deadbandlabs/syncro-mainboard/syncro-pcb-lib/GENERATED.md

<!-- Generated by tools/vendor_lib.py (do not edit). -->

# syncro-pcb-lib

- source library revision: 80b2298
- contents: 16 footprints, 9 symbols (dbl-ic 7, dbl-mech 2)
- symbols: dbl-ic.kicad_sym, dbl-mech.kicad_sym
- 3D models are not redistributed: footprints referencing them fall back
  to no model, which KiCad reports as a missing-model warning.
- parts of this library are derived from the KiCad libraries
  (CC-BY-SA-4.0 WITH KiCad-libraries-exception); see ../NOTICE.
