deadbandlabs/syncro-mainboard/syncro-mainboard/syncro-mainboard.kicad_pcb

## KiCad design syncro-mainboard/syncro-mainboard.kicad_pcb (2026-10-27)

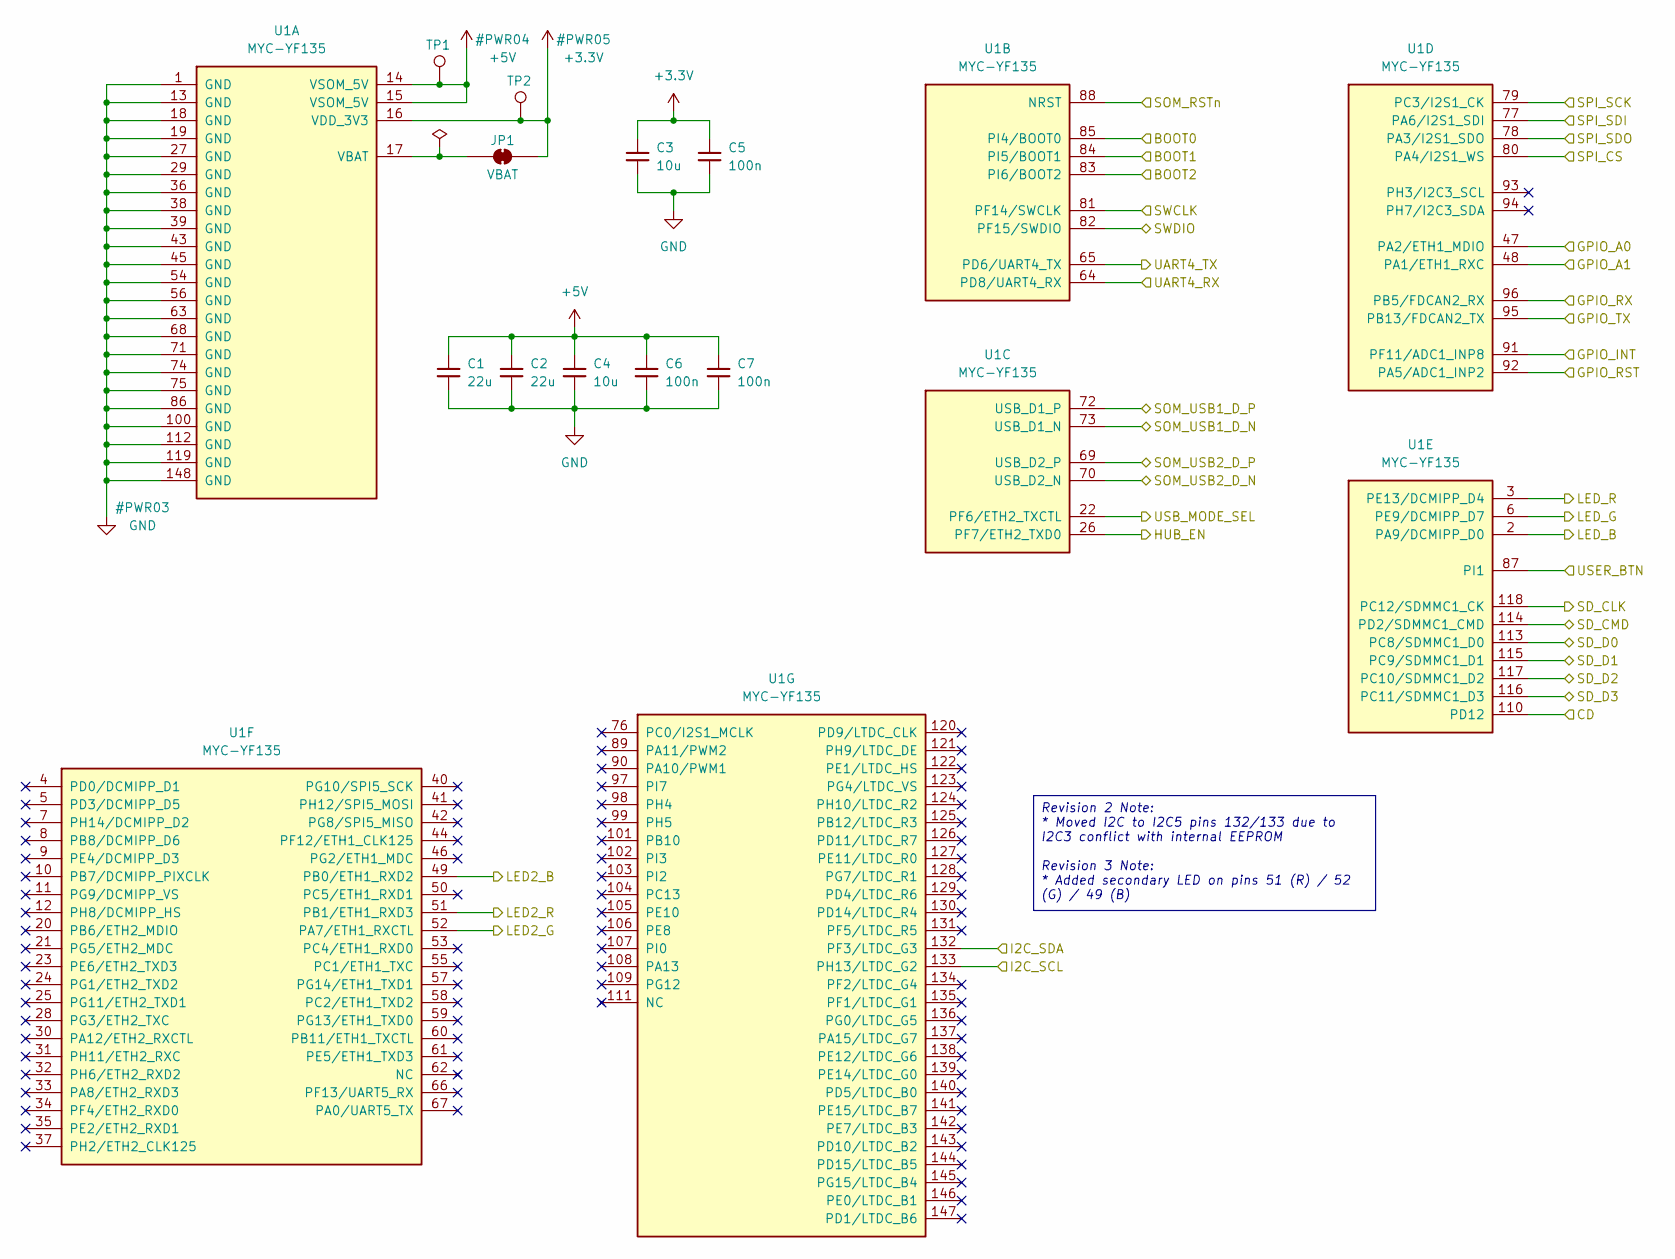
[picture p3: schematic som.kicad_sch, Syncro FFB Interceptor]

Parts:
C1, C2: 22u; C_0805_2012Metric; LCSC C45783
C3, C4: 10u; C_0805_2012Metric; LCSC C15850
C5, C6, C7: 100n; C_0402_1005Metric; LCSC C1525
JP1: VBAT; SolderJumper-2_P1.3mm_Bridged_RoundedPad1.0x1.5mm
TP1: 5V; TestPoint_Pad_D1.5mm
TP2: 3V3; TestPoint_Pad_D1.5mm
U1: MYC-YF135; MPN MYC-YF135F-256N256D-100-I

Connections:
+3.3V: C3.1, C5.1, JP1.2 (B), TP2.1 (1_1), U1.16 (VDD_3V3); also elsewhere on the board
+5V: C1.1, C2.1, C4.1, C6.1, C7.1, TP1.1 (1_1), U1.14 (VSOM_5V), U1.15 (VSOM_5V); also elsewhere on the board
/Debug/BOOT0: U1.85 (PI4/BOOT0); also elsewhere on the board
/Debug/BOOT1: U1.84 (PI5/BOOT1); also elsewhere on the board
/Debug/BOOT2: U1.83 (PI6/BOOT2); also elsewhere on the board
/Debug/SOM_RSTn: U1.88 (NRST); also elsewhere on the board
/Debug/SWCLK: U1.81 (PF14/SWCLK); also elsewhere on the board
/Debug/SWDIO: U1.82 (PF15/SWDIO); also elsewhere on the board
/Debug/UART4_RX: U1.64 (PD8/UART4_RX); also elsewhere on the board
/Debug/UART4_TX: U1.65 (PD6/UART4_TX); also elsewhere on the board
/STM32MP13 SOM/GPIO_A0: U1.47 (PA2/ETH1_MDIO); also elsewhere on the board
/STM32MP13 SOM/GPIO_A1: U1.48 (PA1/ETH1_RXC); also elsewhere on the board
/STM32MP13 SOM/GPIO_INT: U1.91 (PF11/ADC1_INP8); also elsewhere on the board
/STM32MP13 SOM/GPIO_RST: U1.92 (PA5/ADC1_INP2); also elsewhere on the board
/STM32MP13 SOM/GPIO_RX: U1.96 (PB5/FDCAN2_RX); also elsewhere on the board
/STM32MP13 SOM/GPIO_TX: U1.95 (PB13/FDCAN2_TX); also elsewhere on the board
/STM32MP13 SOM/HUB_EN: U1.26 (PF7/ETH2_TXD0); also elsewhere on the board
/STM32MP13 SOM/I2C_SCL: U1.133 (PH13/LTDC_G2); also elsewhere on the board
/STM32MP13 SOM/I2C_SDA: U1.132 (PF3/LTDC_G3); also elsewhere on the board
/STM32MP13 SOM/LED2_B: U1.49 (PB0/ETH1_RXD2); also elsewhere on the board
/STM32MP13 SOM/LED2_G: U1.52 (PA7/ETH1_RXCTL); also elsewhere on the board
/STM32MP13 SOM/LED2_R: U1.51 (PB1/ETH1_RXD3); also elsewhere on the board
/STM32MP13 SOM/LED_B: U1.2 (PA9/DCMIPP_D0); also elsewhere on the board
/STM32MP13 SOM/LED_G: U1.6 (PE9/DCMIPP_D7); also elsewhere on the board
/STM32MP13 SOM/LED_R: U1.3 (PE13/DCMIPP_D4); also elsewhere on the board
/STM32MP13 SOM/SD_CLK: U1.118 (PC12/SDMMC1_CK); also elsewhere on the board
/STM32MP13 SOM/SD_CMD: U1.114 (PD2/SDMMC1_CMD); also elsewhere on the board
/STM32MP13 SOM/SD_D0: U1.113 (PC8/SDMMC1_D0); also elsewhere on the board
/STM32MP13 SOM/SD_D1: U1.115 (PC9/SDMMC1_D1); also elsewhere on the board
/STM32MP13 SOM/SD_D2: U1.117 (PC10/SDMMC1_D2); also elsewhere on the board
/STM32MP13 SOM/SD_D3: U1.116 (PC11/SDMMC1_D3); also elsewhere on the board
/STM32MP13 SOM/SOM_USB1_D_N: U1.73 (USB_D1_N); also elsewhere on the board
/STM32MP13 SOM/SOM_USB1_D_P: U1.72 (USB_D1_P); also elsewhere on the board
/STM32MP13 SOM/SOM_USB2_D_N: U1.70 (USB_D2_N); also elsewhere on the board
/STM32MP13 SOM/SOM_USB2_D_P: U1.69 (USB_D2_P); also elsewhere on the board
/STM32MP13 SOM/SPI_CS: U1.80 (PA4/I2S1_WS); also elsewhere on the board
/STM32MP13 SOM/SPI_SCK: U1.79 (PC3/I2S1_CK); also elsewhere on the board
/STM32MP13 SOM/SPI_SDI: U1.77 (PA6/I2S1_SDI); also elsewhere on the board
/STM32MP13 SOM/SPI_SDO: U1.78 (PA3/I2S1_SDO); also elsewhere on the board
/STM32MP13 SOM/USB_MODE_SEL: U1.22 (PF6/ETH2_TXCTL); also elsewhere on the board
/STM32MP13 SOM/USER_BTN: U1.87 (PI1); also elsewhere on the board
/System IO/CD: U1.110 (PD12); also elsewhere on the board
GND: C1.2, C2.2, C3.2, C4.2, C5.2, C6.2, C7.2, U1.1 (GND), U1.13 (GND), U1.18 (GND), U1.19 (GND), U1.27 (GND), U1.29 (GND), U1.36 (GND), U1.38 (GND), U1.39 (GND), U1.43 (GND), U1.45 (GND), U1.54 (GND), U1.56 (GND), U1.63 (GND), U1.68 (GND), U1.71 (GND), U1.74 (GND), U1.75 (GND), U1.86 (GND), U1.100 (GND), U1.112 (GND), U1.119 (GND), U1.148 (GND); also elsewhere on the board
unnamed: JP1.1 (A), U1.17 (VBAT)

Notes on the sheet:
Revision 2 Note: * Moved I2C to I2C5 pins 132/133 due to I2C3 conflict with internal EEPROM Revision 3 Note: * Added secondary LED on pins 51 (R) / 52 (G) / 49 (B)

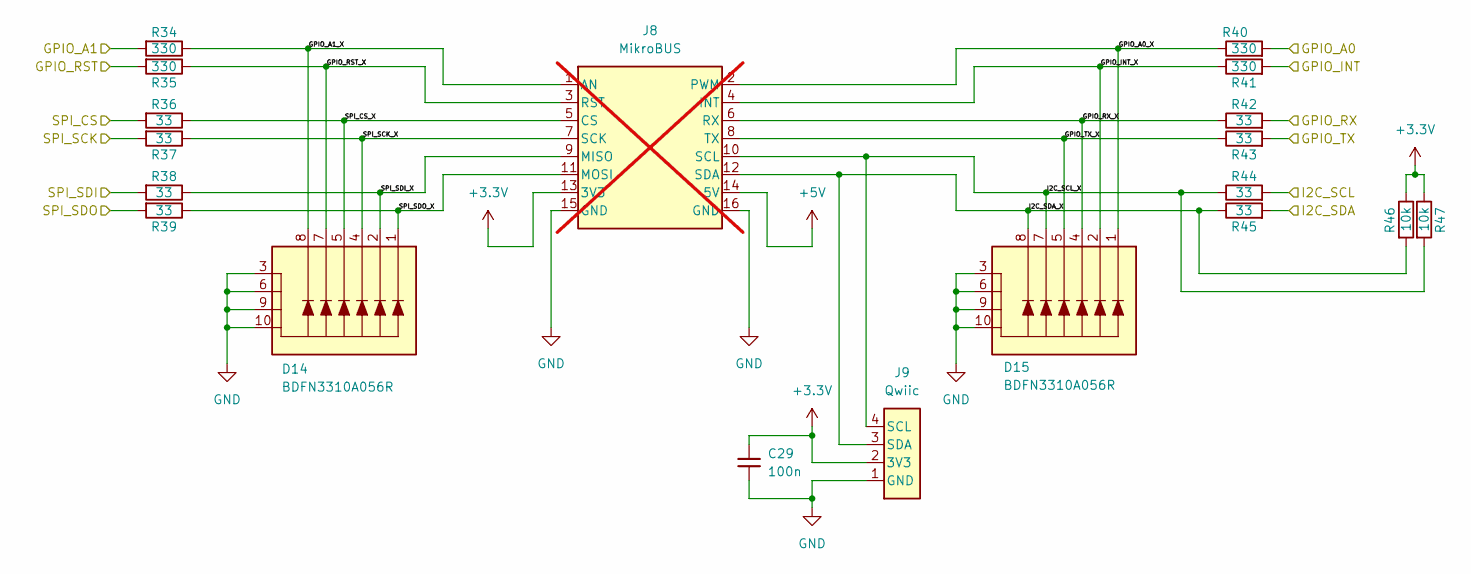
[picture p4: schematic gpio.kicad_sch, Syncro FFB Interceptor]

Parts:
C29: 100n; C_0402_1005Metric; LCSC C1525
D14, D15: BDFN3310A056R; BDFN3310-10_3.3x1.0mm_P0.4mm; LCSC C600810
J8: MikroBUS; MikroBUS_Socket_2x1x08_P2.54mm; not fitted
J9: Qwiic; JST_SH_SM04B-SRSS-TB_1x04-1MP_P1.00mm_Horizontal; LCSC C2905006
R34, R35, R40, R41: 330; R_0402_1005Metric; LCSC C25104
R36, R37, R38, R39, R42, R43, R44, R45: 33; R_0402_1005Metric; LCSC C25105
R46, R47: 10k; R_0402_1005Metric; LCSC C25744

Connections:
+3.3V: C29.1, J8.13 (3V3), J9.2 (3V3), R46.1, R47.1; also elsewhere on the board
+5V: J8.14 (5V); also elsewhere on the board
/STM32MP13 SOM/GPIO_A0: R40.2; also elsewhere on the board
/STM32MP13 SOM/GPIO_A1: R34.2; also elsewhere on the board
/STM32MP13 SOM/GPIO_INT: R41.2; also elsewhere on the board
/STM32MP13 SOM/GPIO_RST: R35.2; also elsewhere on the board
/STM32MP13 SOM/GPIO_RX: R42.2; also elsewhere on the board
/STM32MP13 SOM/GPIO_TX: R43.2; also elsewhere on the board
/STM32MP13 SOM/I2C_SCL: R44.2; also elsewhere on the board
/STM32MP13 SOM/I2C_SDA: R45.2; also elsewhere on the board
/STM32MP13 SOM/SPI_CS: R36.2; also elsewhere on the board
/STM32MP13 SOM/SPI_SCK: R37.2; also elsewhere on the board
/STM32MP13 SOM/SPI_SDI: R38.2; also elsewhere on the board
/STM32MP13 SOM/SPI_SDO: R39.2; also elsewhere on the board
/User GPIO/GPIO_A0_X: D15.1 (IO1), J8.2 (PWM), R40.1
/User GPIO/GPIO_A1_X: D14.8 (IO6), J8.1 (AN), R34.1
/User GPIO/GPIO_INT_X: D15.2 (IO2), J8.4 (INT), R41.1
/User GPIO/GPIO_RST_X: D14.7 (IO5), J8.3 (RST), R35.1
/User GPIO/GPIO_RX_X: D15.4 (IO3), J8.6 (RX), R42.1
/User GPIO/GPIO_TX_X: D15.5 (IO4), J8.8 (TX), R43.1
/User GPIO/I2C_SCL_X: D15.7 (IO5), J8.10 (SCL), J9.4 (SCL), R44.1, R47.2
/User GPIO/I2C_SDA_X: D15.8 (IO6), J8.12 (SDA), J9.3 (SDA), R45.1, R46.2
/User GPIO/SPI_CS_X: D14.5 (IO4), J8.5 (CS), R36.1
/User GPIO/SPI_SCK_X: D14.4 (IO3), J8.7 (SCK), R37.1
/User GPIO/SPI_SDI_X: D14.2 (IO2), J8.9 (MISO), R38.1
/User GPIO/SPI_SDO_X: D14.1 (IO1), J8.11 (MOSI), R39.1
GND: C29.2, D14.3 (GND), D14.6 (GND), D14.9 (GND), D14.10 (GND), D15.3 (GND), D15.6 (GND), D15.9 (GND), D15.10 (GND), J8.15 (GND), J8.16 (GND), J9.1 (GND); also elsewhere on the board

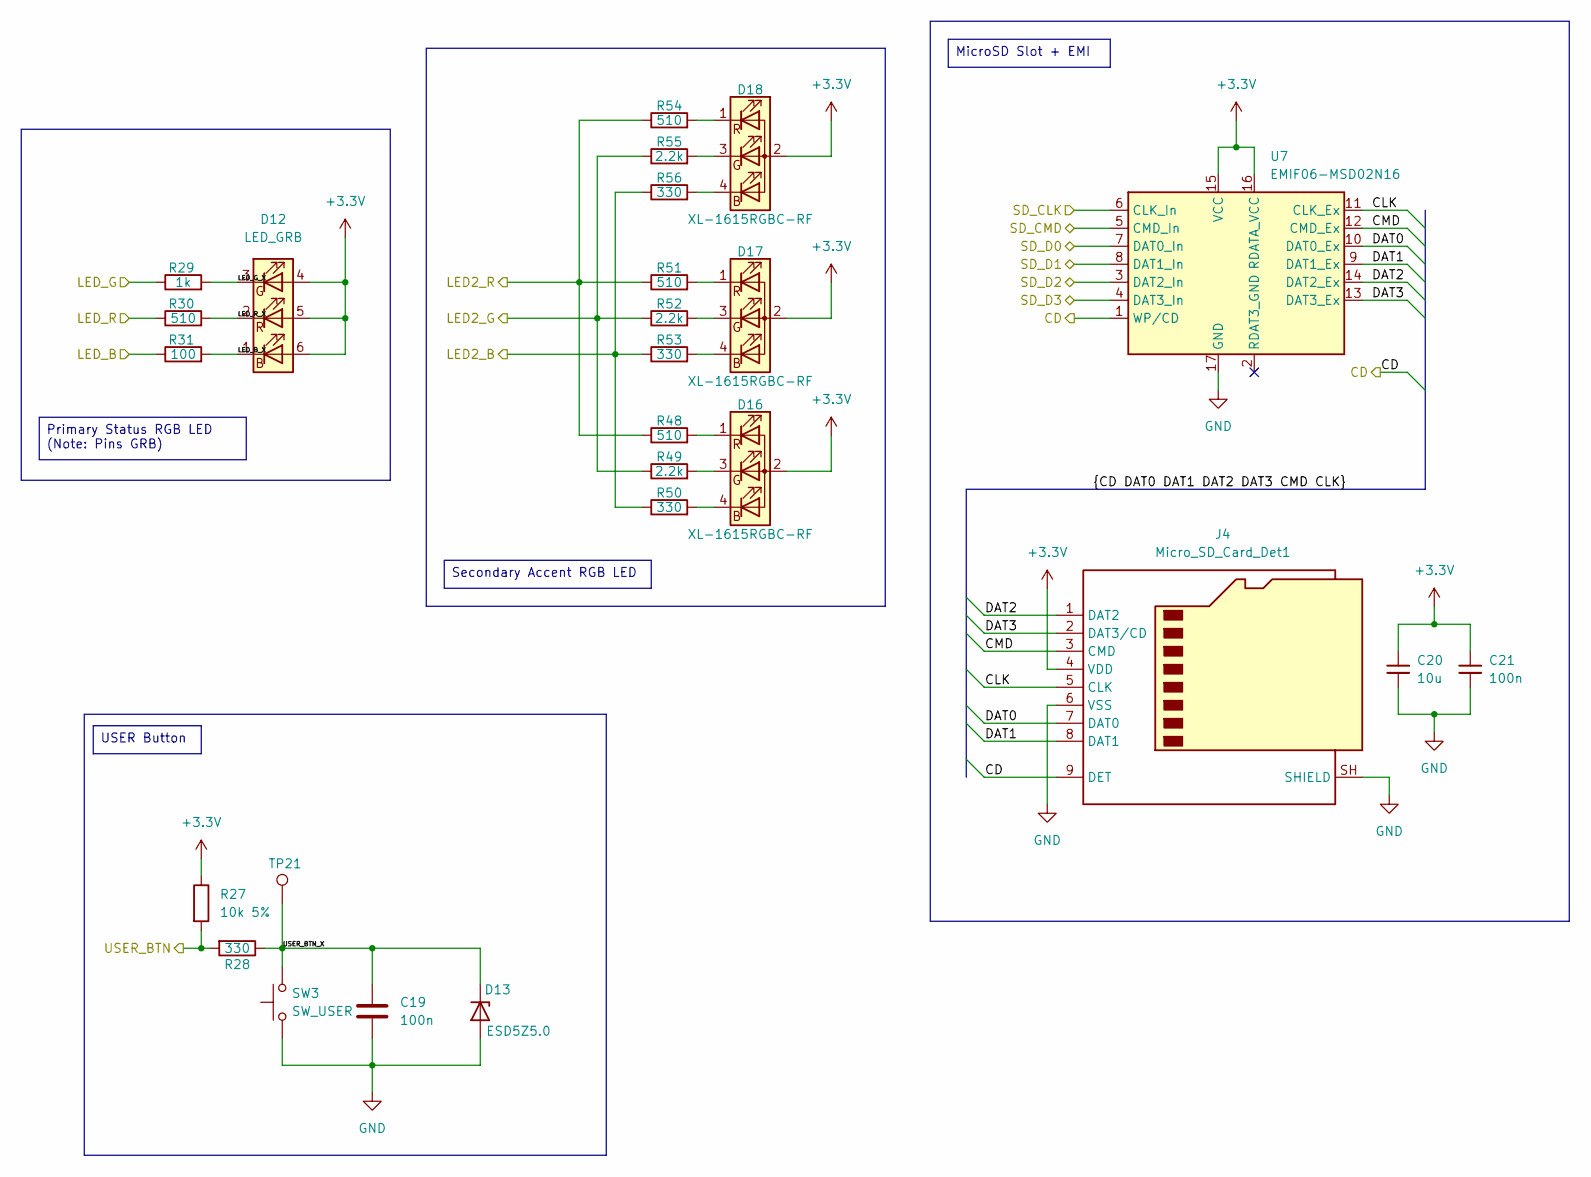
[picture p5: schematic io.kicad_sch, Syncro FFB Interceptor]

Parts:
C19, C21: 100n; C_0402_1005Metric; LCSC C1525
C20: 10u; C_0805_2012Metric; LCSC C15850
D12: LED_GRB; LED_RGB_5050-6; MPN TJ-S5050UG2W5TLCBRG-A5; LCSC C440459
D13: ESD5Z5.0; D_SOD-523; LCSC C3008120
D16, D17, D18: XL-1615RGBC-RF; LED_RGB_XINGLIGHT_XL-1615RGBC; MPN XL-1615RGBC-RF; LCSC C965840
J4: Micro_SD_Card_Det1; microSD_SHOUHAN_TF-CARD-H1.8-SY; MPN TF-CARD H1.8 SY; LCSC C7529391
R27: 10k 5%; R_0402_1005Metric; LCSC C25744
R28, R50, R53, R56: 330; R_0402_1005Metric; LCSC C25104
R29: 1k; R_0402_1005Metric; LCSC C11702
R30, R48, R51, R54: 510; R_0402_1005Metric; LCSC C25123
R31: 100; R_0402_1005Metric; LCSC C25076
R49, R52, R55: 2.2k; R_0402_1005Metric; LCSC C25879
SW3: SW_USER; SW_Push_1P1T_NO_E-Switch_TL3301NxxxxxG; LCSC C111608
TP21: BTN; TestPoint_Pad_D1.5mm
U7: EMIF06-MSD02N16; EMIF06-MSD02N16_uQFN-16_3.5x1.2mm_P0.4mm; MPN EMIF06-MSD02N16; LCSC C5267594

Connections:
+3.3V: C20.1, C21.1, D12.4 (GA), D12.5 (RA), D12.6 (BA), D16.2 (A), D17.2 (A), D18.2 (A), J4.4 (VDD), R27.1, U7.15 (VCC), U7.16 (RDATA_VCC); also elsewhere on the board
/STM32MP13 SOM/LED2_B: R50.1, R53.1, R56.1; also elsewhere on the board
/STM32MP13 SOM/LED2_G: R49.1, R52.1, R55.1; also elsewhere on the board
/STM32MP13 SOM/LED2_R: R48.1, R51.1, R54.1; also elsewhere on the board
/STM32MP13 SOM/LED_B: R31.1; also elsewhere on the board
/STM32MP13 SOM/LED_G: R29.1; also elsewhere on the board
/STM32MP13 SOM/LED_R: R30.1; also elsewhere on the board
/STM32MP13 SOM/SD_CLK: U7.6 (CLK_In); also elsewhere on the board
/STM32MP13 SOM/SD_CMD: U7.5 (CMD_In); also elsewhere on the board
/STM32MP13 SOM/SD_D0: U7.7 (DAT0_In); also elsewhere on the board
/STM32MP13 SOM/SD_D1: U7.8 (DAT1_In); also elsewhere on the board
/STM32MP13 SOM/SD_D2: U7.3 (DAT2_In); also elsewhere on the board
/STM32MP13 SOM/SD_D3: U7.4 (DAT3_In); also elsewhere on the board
/STM32MP13 SOM/USER_BTN: R27.2, R28.2; also elsewhere on the board
/System IO/CD: J4.9 (DET), U7.1 (WP/CD); also elsewhere on the board
/System IO/CLK: J4.5 (CLK), U7.11 (CLK_Ex)
/System IO/CMD: J4.3 (CMD), U7.12 (CMD_Ex)
/System IO/DAT0: J4.7 (DAT0), U7.10 (DAT0_Ex)
/System IO/DAT1: J4.8 (DAT1), U7.9 (DAT1_Ex)
/System IO/DAT2: J4.1 (DAT2), U7.14 (DAT2_Ex)
/System IO/DAT3: J4.2 (DAT3/CD), U7.13 (DAT3_Ex)
/System IO/LED_B_X: D12.1 (BK), R31.2
/System IO/LED_G_X: D12.3 (GK), R29.2
/System IO/LED_R_X: D12.2 (RK), R30.2
/System IO/USER_BTN_X: C19.1, D13.1 (K), R28.1, SW3.2, TP21.1 (1_1)
GND: C19.2, C20.2, C21.2, D13.2 (A), J4.6 (VSS), J4.SH (SHIELD), SW3.1, U7.17 (GND); also elsewhere on the board
unnamed: D16.4 (BK), R50.2
unnamed: D16.3 (GK), R49.2
unnamed: D16.1 (RK), R48.2
unnamed: D17.4 (BK), R53.2
unnamed: D17.3 (GK), R52.2
unnamed: D17.1 (RK), R51.2
unnamed: D18.4 (BK), R56.2
unnamed: D18.3 (GK), R55.2
unnamed: D18.1 (RK), R54.2

Notes on the sheet:
MicroSD Slot + EMI
Secondary Accent RGB LED
Primary Status RGB LED (Note: Pins GRB)
USER Button

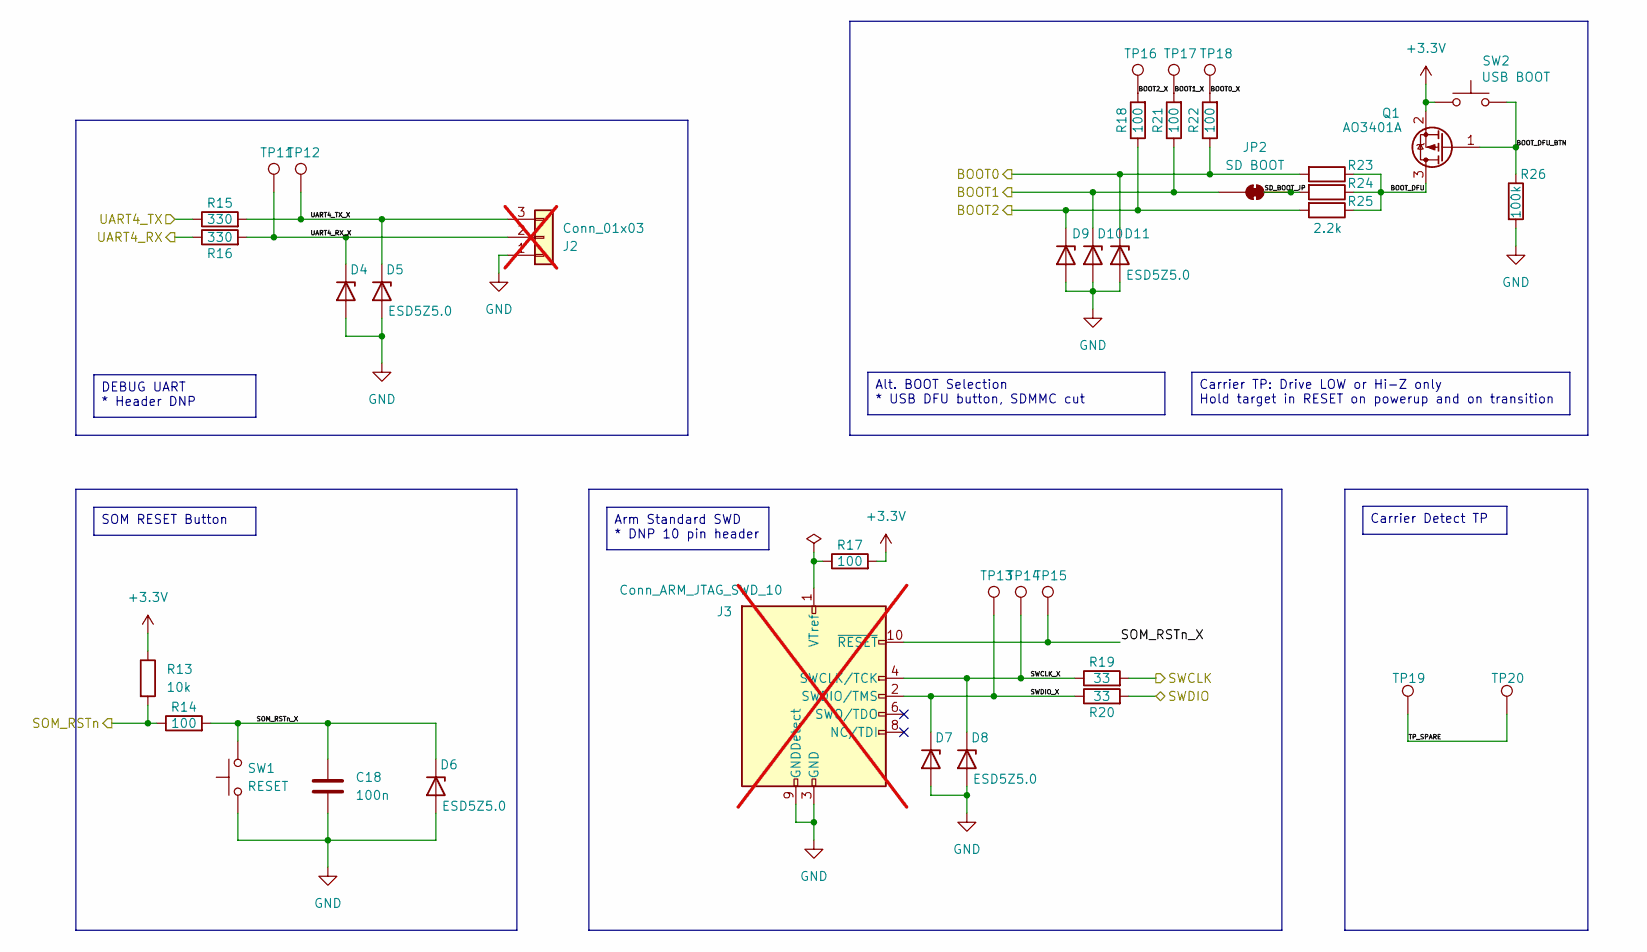
[picture p6: schematic debug.kicad_sch, Syncro FFB Interceptor]

Parts:
C18: 100n; C_0402_1005Metric; LCSC C1525
D4, D5, D6, D7, D8, D9, D10, D11: ESD5Z5.0; D_SOD-523; LCSC C3008120
J2: Conn_01x03; PinHeader_1x03_P2.54mm_Vertical; not fitted
J3: Conn_ARM_JTAG_SWD_10; PinSocket_2x05_P1.27mm_Vertical_SMD; not fitted
JP2: SD BOOT; SolderJumper-2_P1.3mm_Bridged_RoundedPad1.0x1.5mm
Q1: AO3401A; SOT-23; LCSC C15127
R13: 10k; R_0402_1005Metric; LCSC C25744
R14, R17, R18, R21, R22: 100; R_0402_1005Metric; LCSC C25076
R15, R16: 330; R_0402_1005Metric; LCSC C25104
R19, R20: 33; R_0402_1005Metric; LCSC C25105
R23, R24, R25: 2.2k; R_0402_1005Metric; LCSC C25879
R26: 100k; R_0402_1005Metric; LCSC C25741
SW1: RESET; SW_Push_1P1T_XKB_TS-1187A; LCSC C318884
SW2: USB BOOT; SW_Push_1P1T_XKB_TS-1187A; LCSC C318884
TP11: RX; TestPoint_Pad_D1.5mm
TP12: TX; TestPoint_Pad_D1.5mm
TP13: SWCLK; TestPoint_Pad_D1.5mm
TP14: SWDIO; TestPoint_Pad_D1.5mm
TP15: RST; TestPoint_Pad_D1.5mm
TP16: BOOT2; TestPoint_Pad_D1.5mm
TP17: BOOT1; TestPoint_Pad_D1.5mm
TP18: BOOT0; TestPoint_Pad_D1.5mm
TP19: BRD_A; TestPoint_Pad_D1.5mm
TP20: BRD_B; TestPoint_Pad_D1.5mm

Connections:
+3.3V: Q1.2 (S), R13.1, R17.2, SW2.1; also elsewhere on the board
/Debug/BOOT0: D11.1 (K), R22.1, R23.2; also elsewhere on the board
/Debug/BOOT0_X: R22.2, TP18.1 (1_1)
/Debug/BOOT1: D10.1 (K), JP2.1 (A), R21.1; also elsewhere on the board
/Debug/BOOT1_X: R21.2, TP17.1 (1_1)
/Debug/BOOT2: D9.1 (K), R18.1, R25.2; also elsewhere on the board
/Debug/BOOT2_X: R18.2, TP16.1 (1_1)
/Debug/BOOT_DFU: Q1.3 (D), R23.1, R24.1, R25.1
/Debug/BOOT_DFU_BTN: Q1.1 (G), R26.1, SW2.2
/Debug/SD_BOOT_JP: JP2.2 (B), R24.2
/Debug/SOM_RSTn: R13.2, R14.1; also elsewhere on the board
/Debug/SOM_RSTn_X: C18.1, D6.1 (K), J3.10 (~RESET), R14.2, SW1.2, TP15.1 (1_1)
/Debug/SWCLK: R19.2; also elsewhere on the board
/Debug/SWCLK_X: D8.1 (K), J3.4 (SWCLK/TCK), R19.1, TP14.1 (1_1)
/Debug/SWDIO: R20.2; also elsewhere on the board
/Debug/SWDIO_X: D7.1 (K), J3.2 (SWDIO/TMS), R20.1, TP13.1 (1_1)
/Debug/TP_SPARE: TP19.1 (1_1), TP20.1 (1_1)
/Debug/UART4_RX: R16.1; also elsewhere on the board
/Debug/UART4_RX_X: D4.1 (K), J2.2, R16.2, TP11.1 (1_1)
/Debug/UART4_TX: R15.1; also elsewhere on the board
/Debug/UART4_TX_X: D5.1 (K), J2.3, R15.2, TP12.1 (1_1)
GND: C18.2, D4.2 (A), D5.2 (A), D6.2 (A), D7.2 (A), D8.2 (A), D9.2 (A), D10.2 (A), D11.2 (A), J2.1, J3.3 (GND), J3.5 (GND), J3.9 (GNDDetect), R26.2, SW1.1; also elsewhere on the board
unnamed: J3.1 (VTref), R17.1

Notes on the sheet:
Arm Standard SWD * DNP 10 pin header
Carrier TP: Drive LOW or Hi-Z only Hold target in RESET on powerup and on transition
Alt. BOOT Selection * USB DFU button, SDMMC cut
Carrier Detect TP
SOM RESET Button
DEBUG UART * Header DNP

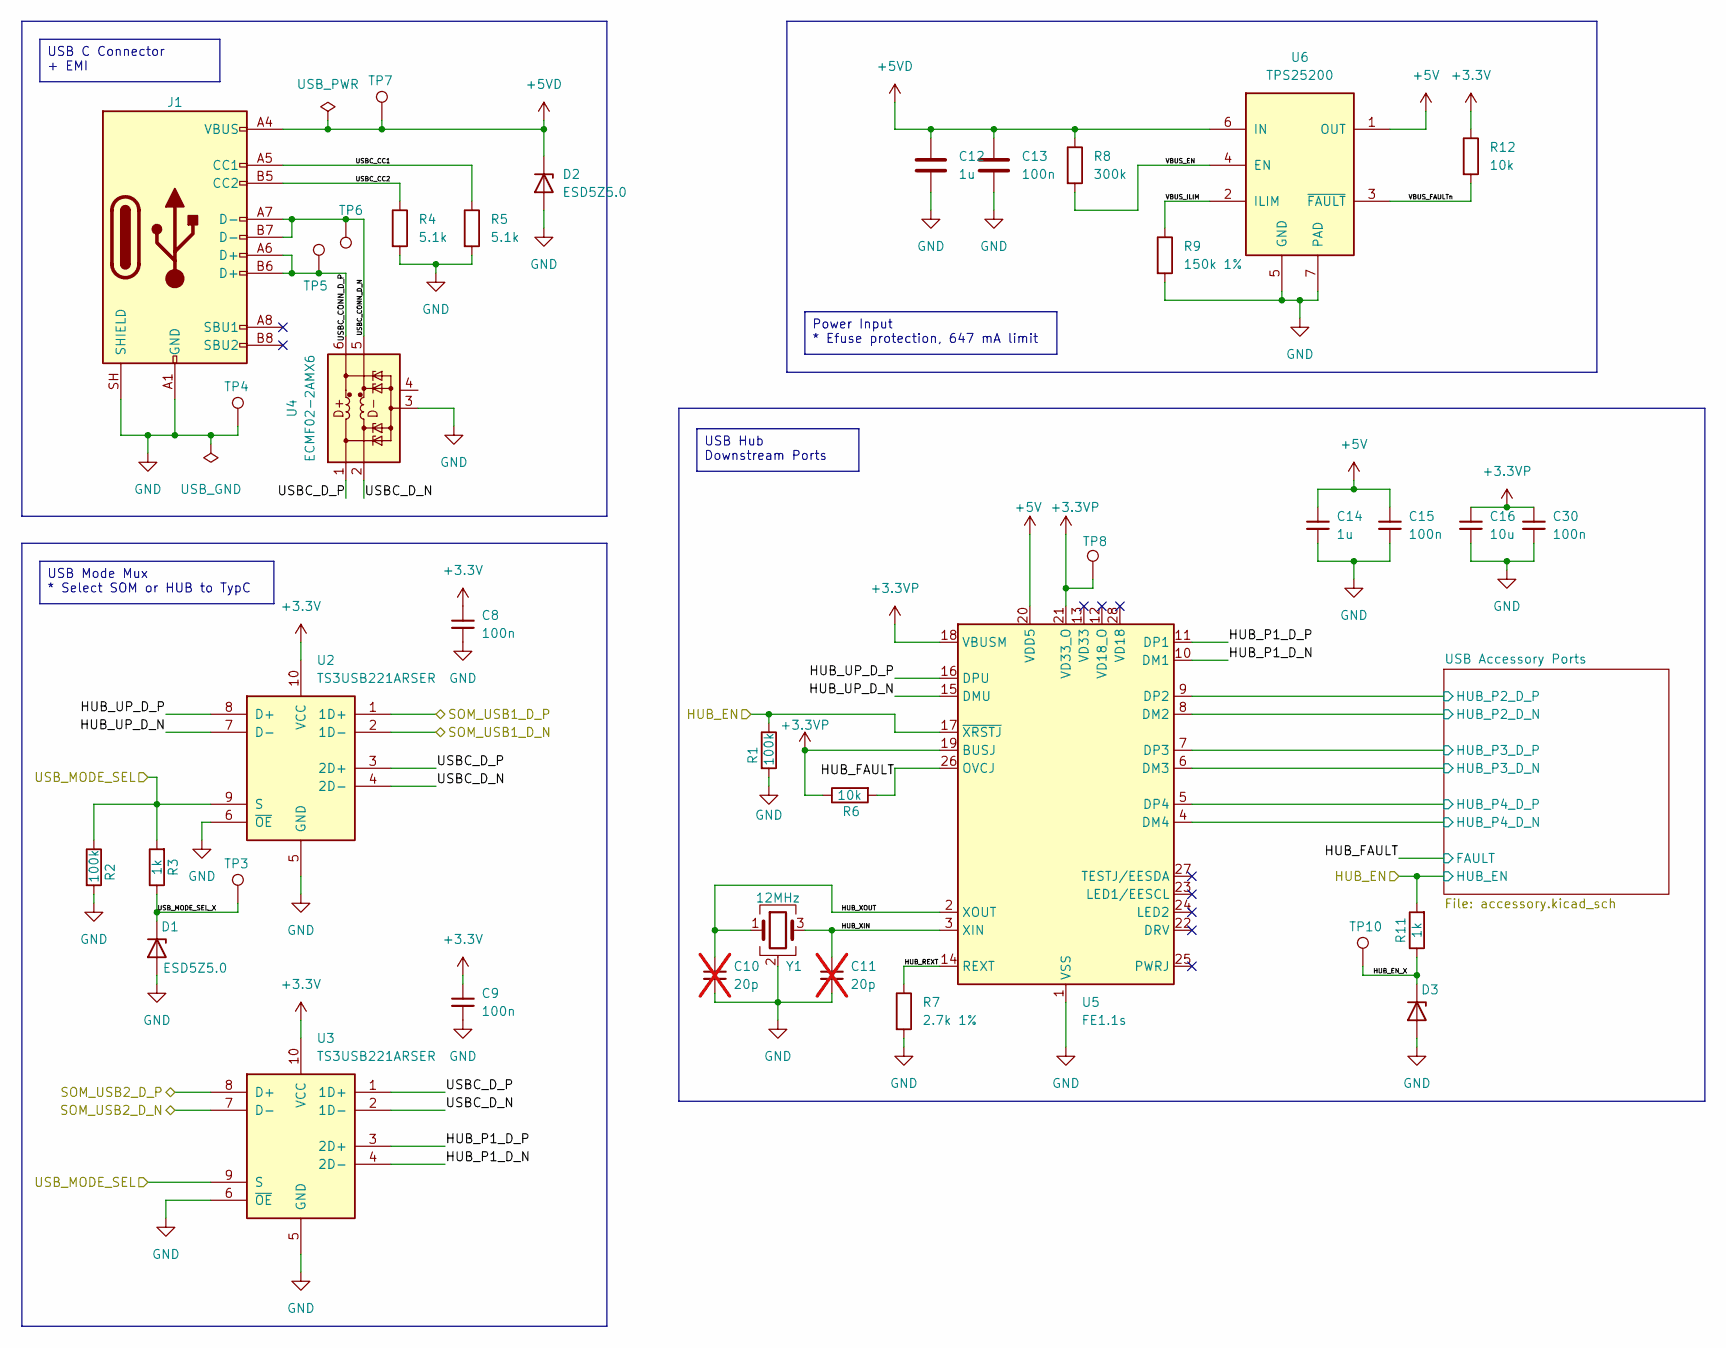
[picture p7: schematic usb.kicad_sch, Syncro FFB Interceptor]

Parts:
C8, C9, C13, C15, C30: 100n; C_0402_1005Metric; LCSC C1525
C10, C11: 20p; C_0402_1005Metric; MPN 0402CG200J500NT; LCSC C1554; not fitted
C12, C14: 1u; C_0402_1005Metric; LCSC C52923
C16: 10u; C_0805_2012Metric; LCSC C15850
D1, D2, D3: ESD5Z5.0; D_SOD-523; LCSC C3008120
J1: USB_C_Receptacle_USB2.0_16P; USB_C_Receptacle_SHOUHAN_TYPE-C-16PIN-2MD-073; MPN TYPE-C-16PIN-2MD-073; LCSC C2765186
R1, R2: 100k; R_0402_1005Metric; LCSC C25741
R3, R11: 1k; R_0402_1005Metric; LCSC C11702
R4, R5: 5.1k; R_0402_1005Metric; LCSC C25905
R6, R12: 10k; R_0402_1005Metric; LCSC C25744
R7: 2.7k 1%; R_0402_1005Metric; LCSC C25885
R8: 300k; R_0402_1005Metric; LCSC C25774
R9: 150k 1%; R_0402_1005Metric; LCSC C25755
TP3: MODE; TestPoint_Pad_D1.5mm
TP4: GND; TestPoint_Pad_D1.5mm
TP5: DP; TestPoint_Pad_D1.5mm
TP6: DM; TestPoint_Pad_D1.5mm
TP7: VBUS; TestPoint_Pad_D1.5mm
TP8: 3V3P; TestPoint_Pad_D1.5mm
TP10: USBEN; TestPoint_Pad_D1.5mm
U2, U3: TS3USB221ARSER; Texas_UQFN-10_1.5x2mm_P0.5mm; MPN TS3USB221ARSER; LCSC C128396
U4: ECMF02-2AMX6; ST_UQFN-6L_1.5x1.7mm_P0.5mm; MPN ECMF02-2AMX6; LCSC C2651144
U5: FE1.1s; SSOP-28_3.9x9.9mm_P0.635mm; MPN FE1.1S-BSOP28BCNTR; LCSC C42383361
U6: TPS25200; WSON-6-1EP_2x2mm_P0.65mm_EP1x1.6mm_ThermalVias_0.3mm; MPN TPS25200DRVR; LCSC C128401
Y1: 12MHz; Crystal_SMD_3225-4Pin_3.2x2.5mm; MPN X322512MSB4SI; LCSC C9002

Connections:
+3.3V: C8.1, C9.1, R12.1, U2.10 (VCC), U3.10 (VCC); also elsewhere on the board
+3.3VP: C16.1, C30.1, R6.1, TP8.1 (1_1), U5.18 (VBUSM), U5.19 (BUSJ), U5.21 (VD33_O)
+5V: C14.1, C15.1, U5.20 (VDD5), U6.1 (OUT); also elsewhere on the board
+5VD: C12.1, C13.1, D2.1 (K), J1.A4 (VBUS), J1.A9 (VBUS), J1.B4 (VBUS), J1.B9 (VBUS), R8.1, TP7.1 (1_1), U6.6 (IN)
/STM32MP13 SOM/HUB_EN: R1.1, R11.2, U5.17 (~XRSTJ); also elsewhere on the board
/STM32MP13 SOM/SOM_USB1_D_N: U2.2 (1D-); also elsewhere on the board
/STM32MP13 SOM/SOM_USB1_D_P: U2.1 (1D+); also elsewhere on the board
/STM32MP13 SOM/SOM_USB2_D_N: U3.7 (D-); also elsewhere on the board
/STM32MP13 SOM/SOM_USB2_D_P: U3.8 (D+); also elsewhere on the board
/STM32MP13 SOM/USB_MODE_SEL: R2.1, R3.2, U2.9 (S), U3.9 (S); also elsewhere on the board
/USB Mux/HUB_EN_X: D3.1 (K), R11.1, TP10.1 (1_1)
/USB Mux/HUB_FAULT: R6.2, U5.26 (OVCJ); also elsewhere on the board
/USB Mux/HUB_P1_D_N: U3.4 (2D-), U5.10 (DM1)
/USB Mux/HUB_P1_D_P: U3.3 (2D+), U5.11 (DP1)
/USB Mux/HUB_REXT: R7.1, U5.14 (REXT)
/USB Mux/HUB_UP_D_N: U2.7 (D-), U5.15 (DMU)
/USB Mux/HUB_UP_D_P: U2.8 (D+), U5.16 (DPU)
/USB Mux/HUB_XIN: C11.1, U5.3 (XIN), Y1.3
/USB Mux/HUB_XOUT: C10.1, U5.2 (XOUT), Y1.1
/USB Mux/USB Accessory Ports/HUB_P2_D_N: U5.8 (DM2); also elsewhere on the board
/USB Mux/USB Accessory Ports/HUB_P2_D_P: U5.9 (DP2); also elsewhere on the board
/USB Mux/USB Accessory Ports/HUB_P3_D_N: U5.6 (DM3); also elsewhere on the board
/USB Mux/USB Accessory Ports/HUB_P3_D_P: U5.7 (DP3); also elsewhere on the board
/USB Mux/USB Accessory Ports/HUB_P4_D_N: U5.4 (DM4); also elsewhere on the board
/USB Mux/USB Accessory Ports/HUB_P4_D_P: U5.5 (DP4); also elsewhere on the board
/USB Mux/USBC_CC1: J1.A5 (CC1), R5.1
/USB Mux/USBC_CC2: J1.B5 (CC2), R4.1
/USB Mux/USBC_CONN_D_N: J1.A7 (D-), J1.B7 (D-), TP6.1 (1_1), U4.5 (D-_out)
/USB Mux/USBC_CONN_D_P: J1.A6 (D+), J1.B6 (D+), TP5.1 (1_1), U4.6 (D+_out)
/USB Mux/USBC_D_N: U2.4 (2D-), U3.2 (1D-), U4.2 (D-_in)
/USB Mux/USBC_D_P: U2.3 (2D+), U3.1 (1D+), U4.1 (D+_in)
/USB Mux/USB_MODE_SEL_X: D1.1 (K), R3.1, TP3.1 (1_1)
/USB Mux/VBUS_EN: R8.2, U6.4 (EN)
/USB Mux/VBUS_FAULTn: R12.2, U6.3 (~FAULT)
/USB Mux/VBUS_ILIM: R9.1, U6.2 (ILIM)
GND: C8.2, C9.2, C10.2, C11.2, C12.2, C13.2, C14.2, C15.2, C16.2, C30.2, D1.2 (A), D2.2 (A), D3.2 (A), J1.A1 (GND), J1.A12 (GND), J1.B1 (GND), J1.B12 (GND), J1.SH (SHIELD), R1.2, R2.2, R4.2, R5.2, R7.2, R9.2, TP4.1 (1_1), U2.5 (GND), U2.6 (~OE), U3.5 (GND), U3.6 (~OE), U4.3 (GND), U5.1 (VSS), U6.5 (GND), U6.7 (PAD), Y1.2 (G), Y1.4 (G); also elsewhere on the board

Notes on the sheet:
Power Input * Efuse protection, 647 mA limit
USB Mode Mux * Select SOM or HUB to TypC
USB Hub Downstream Ports
USB C Connector + EMI

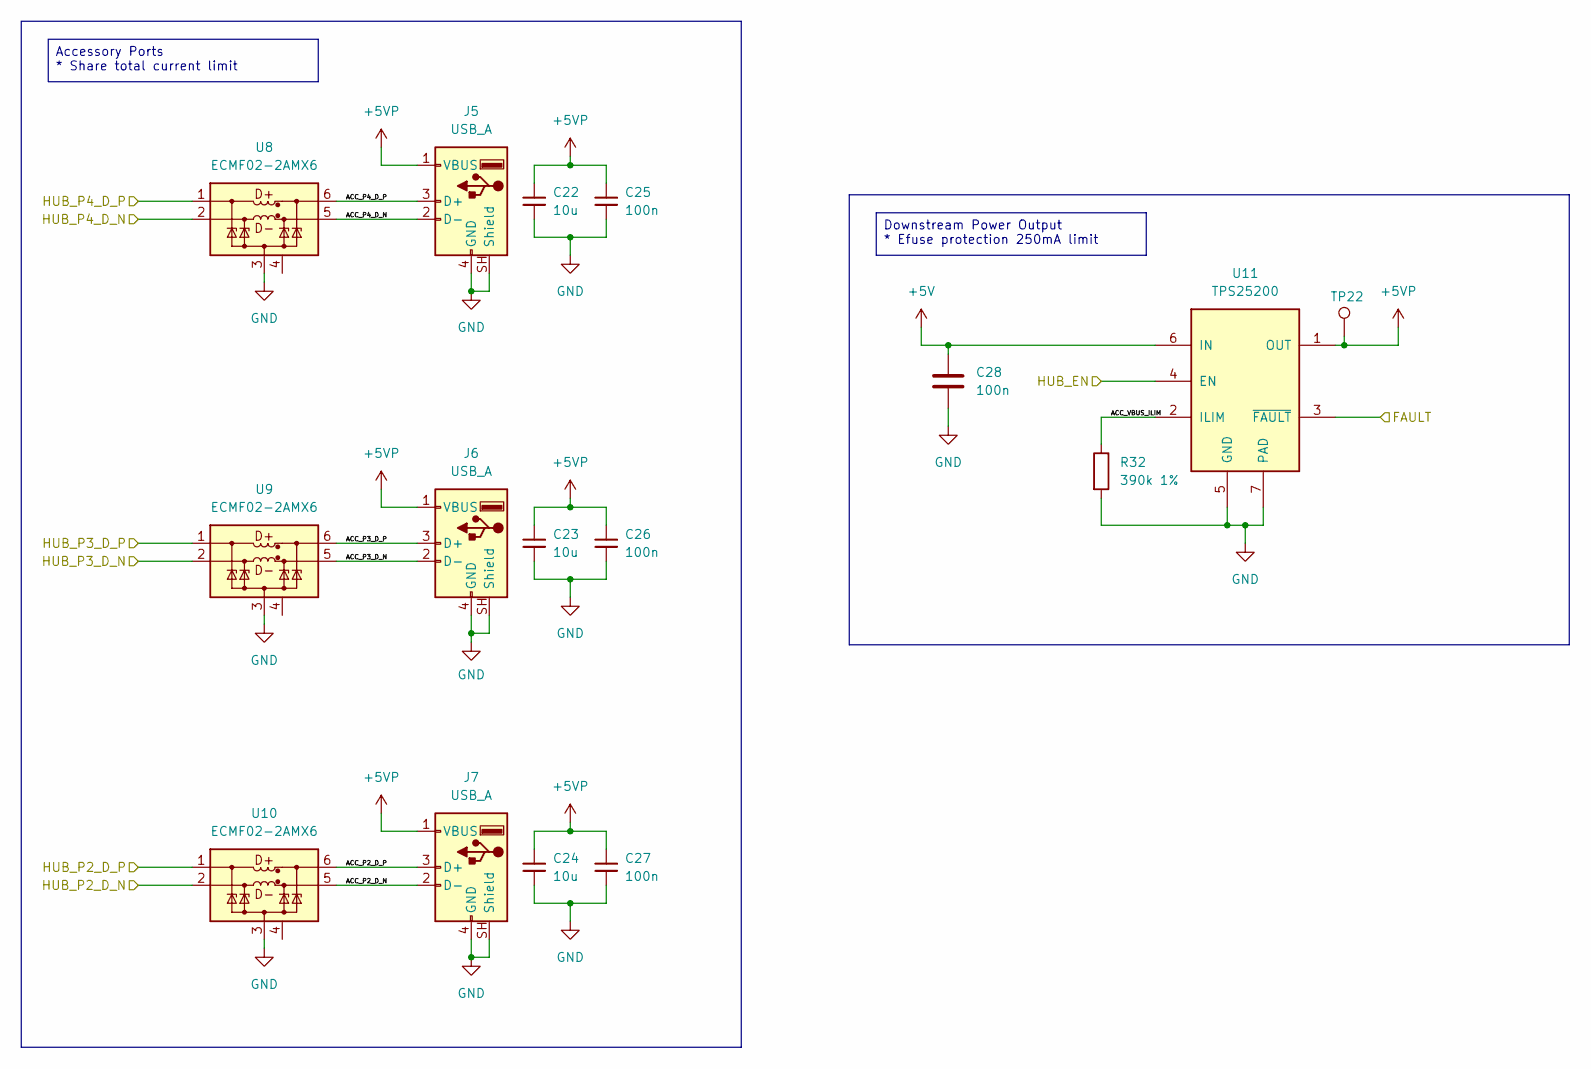
[picture p8: schematic accessory.kicad_sch, Syncro FFB Interceptor]

Parts:
C22, C23, C24: 10u; C_0805_2012Metric; LCSC C15850
C25, C26, C27, C28: 100n; C_0402_1005Metric; LCSC C1525
J5, J6, J7: USB_A; USB_A_SHOUHAN_10.0-QTJ6.3_Horizontal; LCSC C404966
R32: 390k 1%; R_0402_1005Metric; LCSC C25782
TP22: VUSB; TestPoint_Pad_D1.5mm
U8, U9, U10: ECMF02-2AMX6; ST_UQFN-6L_1.5x1.7mm_P0.5mm; MPN ECMF02-2AMX6; LCSC C2651144
U11: TPS25200; WSON-6-1EP_2x2mm_P0.65mm_EP1x1.6mm_ThermalVias_0.3mm; MPN TPS25200DRVR; LCSC C128401

Connections:
+5V: C28.1, U11.6 (IN); also elsewhere on the board
+5VP: C22.1, C23.1, C24.1, C25.1, C26.1, C27.1, J5.1 (VBUS), J6.1 (VBUS), J7.1 (VBUS), TP22.1 (1_1), U11.1 (OUT)
/STM32MP13 SOM/HUB_EN: U11.4 (EN); also elsewhere on the board
/USB Mux/HUB_FAULT: U11.3 (~FAULT); also elsewhere on the board
/USB Mux/USB Accessory Ports/ACC_P2_D_N: J7.2 (D-), U10.5 (D-_out)
/USB Mux/USB Accessory Ports/ACC_P2_D_P: J7.3 (D+), U10.6 (D+_out)
/USB Mux/USB Accessory Ports/ACC_P3_D_N: J6.2 (D-), U9.5 (D-_out)
/USB Mux/USB Accessory Ports/ACC_P3_D_P: J6.3 (D+), U9.6 (D+_out)
/USB Mux/USB Accessory Ports/ACC_P4_D_N: J5.2 (D-), U8.5 (D-_out)
/USB Mux/USB Accessory Ports/ACC_P4_D_P: J5.3 (D+), U8.6 (D+_out)
/USB Mux/USB Accessory Ports/ACC_VBUS_ILIM: R32.1, U11.2 (ILIM)
/USB Mux/USB Accessory Ports/HUB_P2_D_N: U10.2 (D-_in); also elsewhere on the board
/USB Mux/USB Accessory Ports/HUB_P2_D_P: U10.1 (D+_in); also elsewhere on the board
/USB Mux/USB Accessory Ports/HUB_P3_D_N: U9.2 (D-_in); also elsewhere on the board
/USB Mux/USB Accessory Ports/HUB_P3_D_P: U9.1 (D+_in); also elsewhere on the board
/USB Mux/USB Accessory Ports/HUB_P4_D_N: U8.2 (D-_in); also elsewhere on the board
/USB Mux/USB Accessory Ports/HUB_P4_D_P: U8.1 (D+_in); also elsewhere on the board
GND: C22.2, C23.2, C24.2, C25.2, C26.2, C27.2, C28.2, J5.4 (GND), J5.SH (Shield), J6.4 (GND), J6.SH (Shield), J7.4 (GND), J7.SH (Shield), R32.2, U8.3 (GND), U9.3 (GND), U10.3 (GND), U11.5 (GND), U11.7 (PAD); also elsewhere on the board

Notes on the sheet:
Accessory Ports * Share total current limit
Downstream Power Output * Efuse protection 250mA limit
