deadbandlabs/syncro-mainboard/syncro-mainboard/syncro-mainboard.kicad_pcb

## KiCad design syncro-mainboard/syncro-mainboard.kicad_pcb (continued)

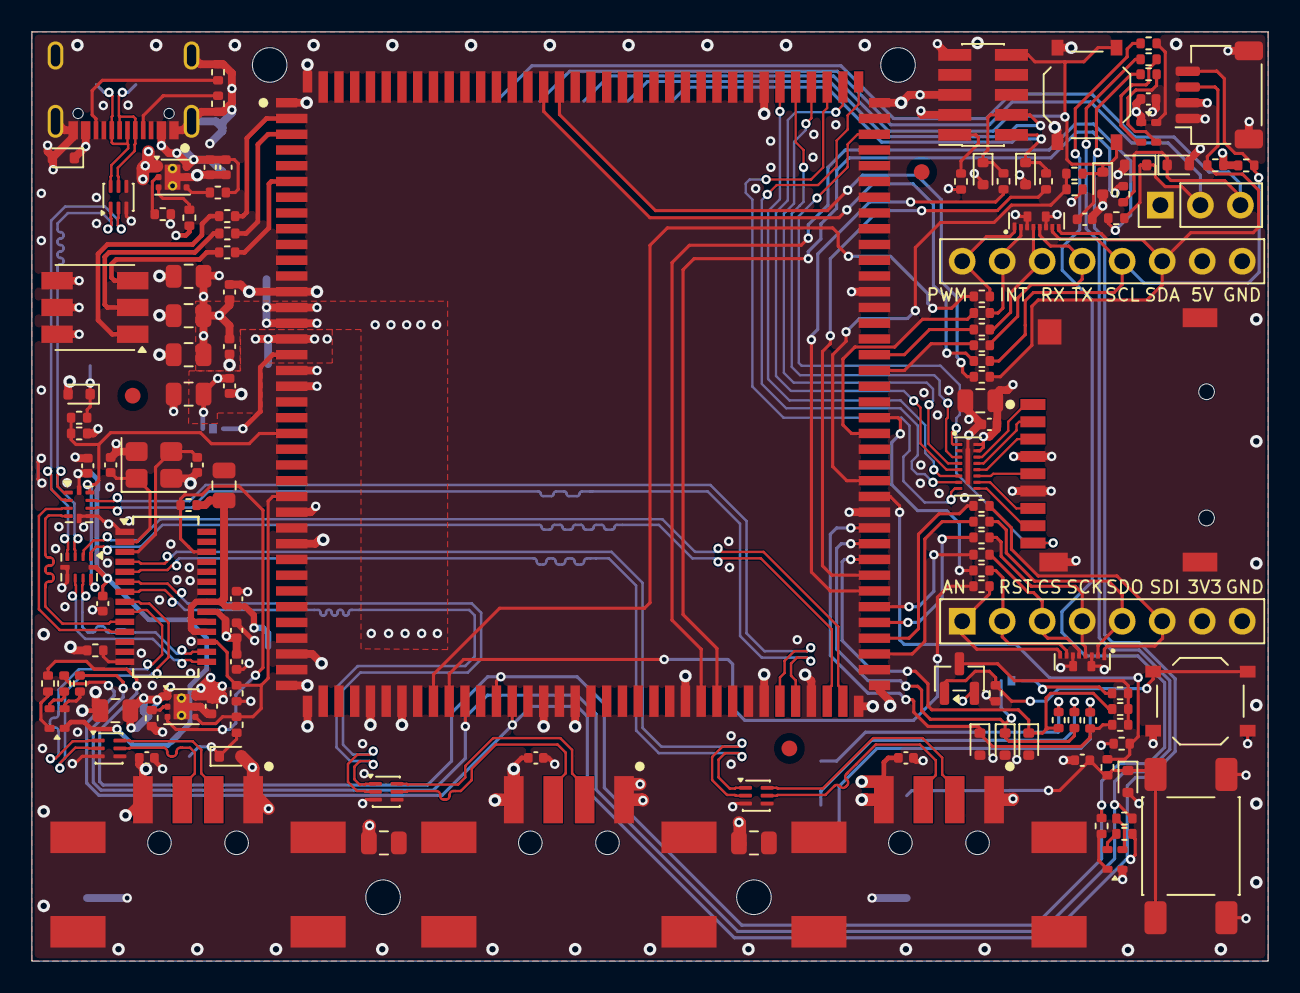
[picture p9: board syncro-mainboard.kicad_pcb from above]

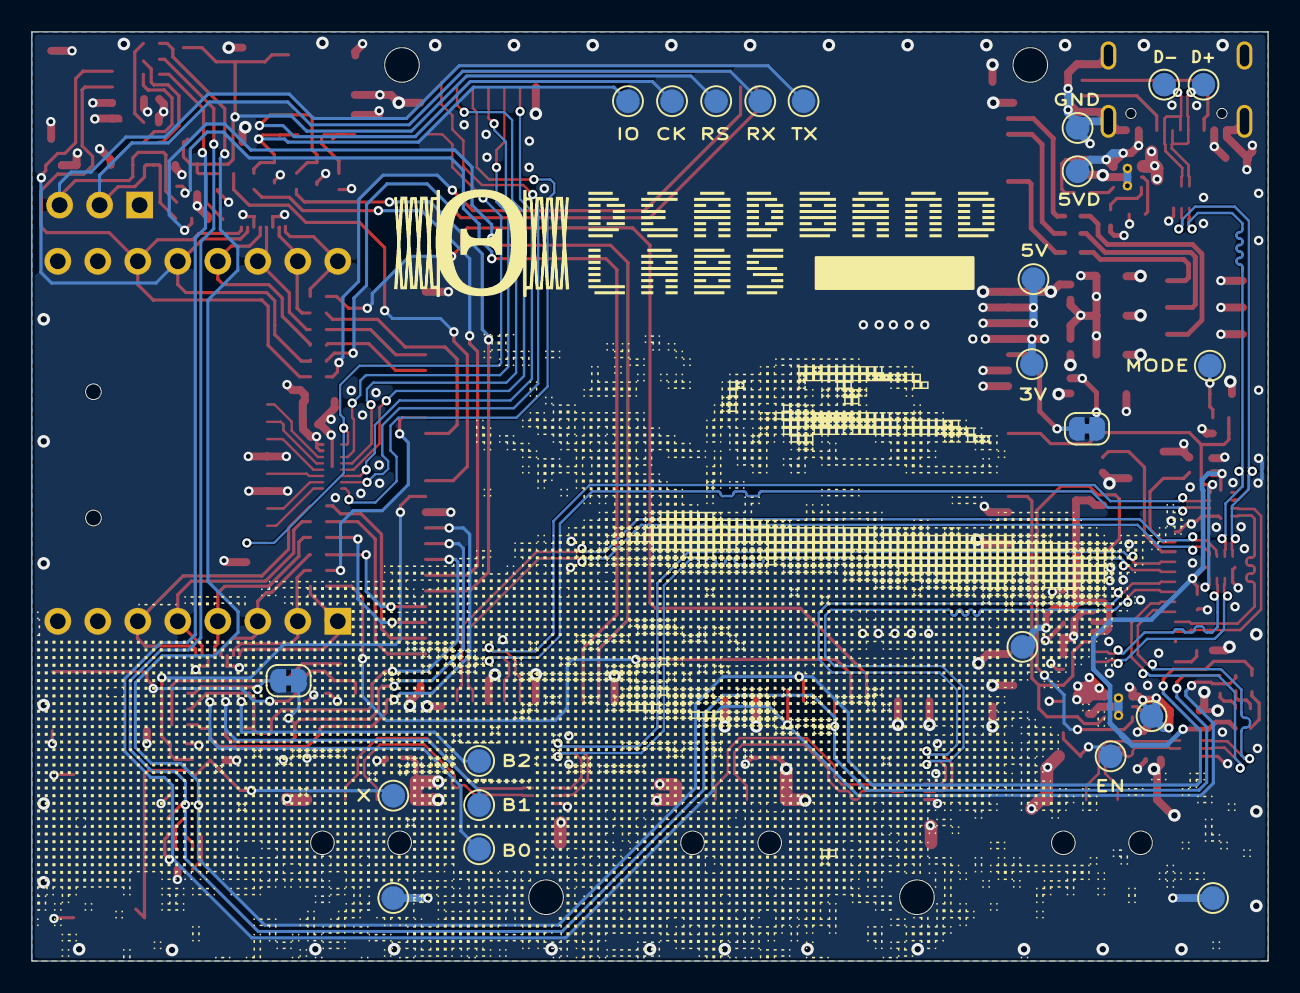
[picture p10: board syncro-mainboard.kicad_pcb from below]

Board: 4 copper layers, 78.5 x 59.0 mm, 149 parts (23 on the bottom side), 123 nets.
