deadbandlabs/syncro-mainboard/(commit log)

2026-10-22 Syncro mainboard rev 1
    [accessory.kicad_sch, debug.kicad_sch, gpio.kicad_sch, io.kicad_sch, som.kicad_sch, syncro-mainboard.kicad_pcb, syncro-mainboard.kicad_sch, usb.kicad_sch]
2026-10-23 Correct SMD5050 LED rotation
    [io.kicad_sch, syncro-mainboard.kicad_pcb]
2026-10-23 Syncro mainboard rev 2
    * Migrate I2C to I2C5 on SOM pins 132/133
    * Use correctly reversed LED footprint
    * Use updated rear graphics
    * Set SOM to be assembled at JLC
    [accessory.kicad_sch, debug.kicad_sch, gpio.kicad_sch, io.kicad_sch, som.kicad_sch, syncro-mainboard.kicad_pcb, syncro-mainboard.kicad_sch, usb.kicad_sch]
2026-10-27 Syncro mainboard rev 3
    * Add XL-1615 accent RGB LEDs D16-D18 on TIM8
    * Add R48-R56 next to the LEDs and rework their shared +3.3V feed
    * Add In2 GND return plane under the USB-C connector for TP5/TP6
    [io.kicad_sch, som.kicad_sch, syncro-mainboard.kicad_pcb, syncro-mainboard.kicad_sch]
